ErkkaWS/3D-Robotics-H.E.I.K.K.I/Additional Documentation/20260302_133144.jpg

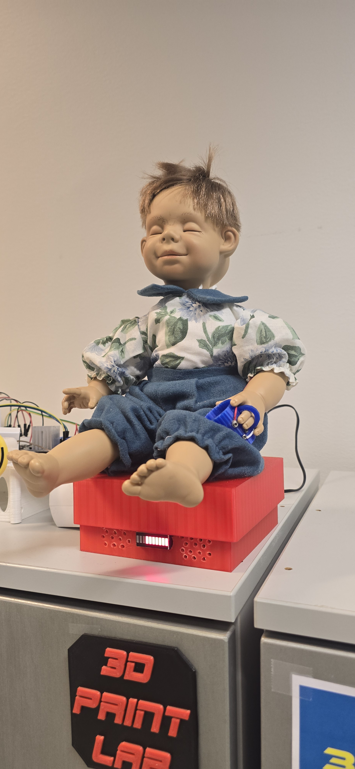
Additional Documentation/20260302_133144.jpg
