ErkkaWS/3D-Robotics-H.E.I.K.K.I/Additional Documentation/IMG-20260227-WA0012 (2).jpg

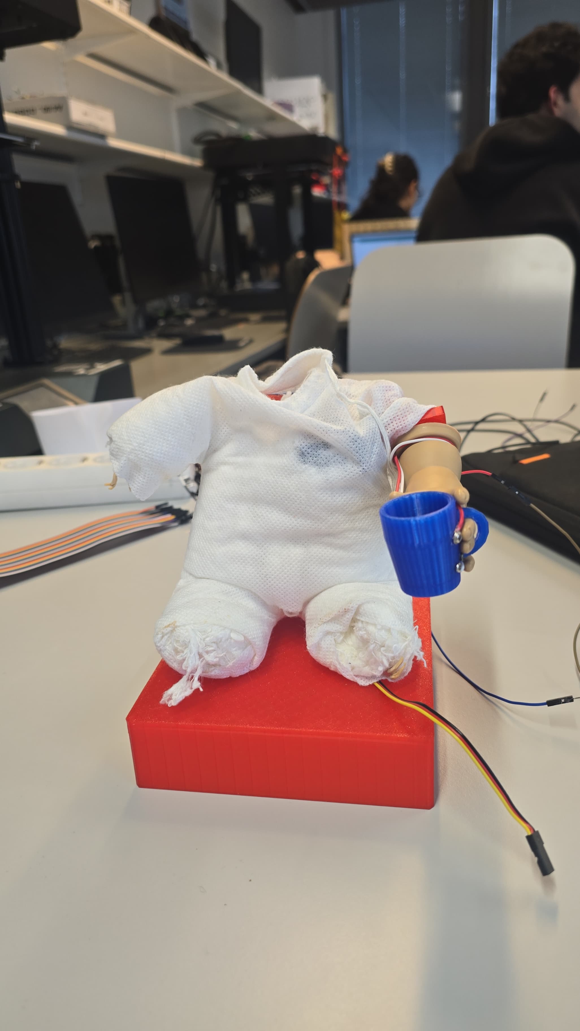
Additional Documentation/IMG-20260227-WA0012 (2).jpg
