ErkkaWS/3D-Robotics-H.E.I.K.K.I/Additional Documentation/20260226_091918.jpg

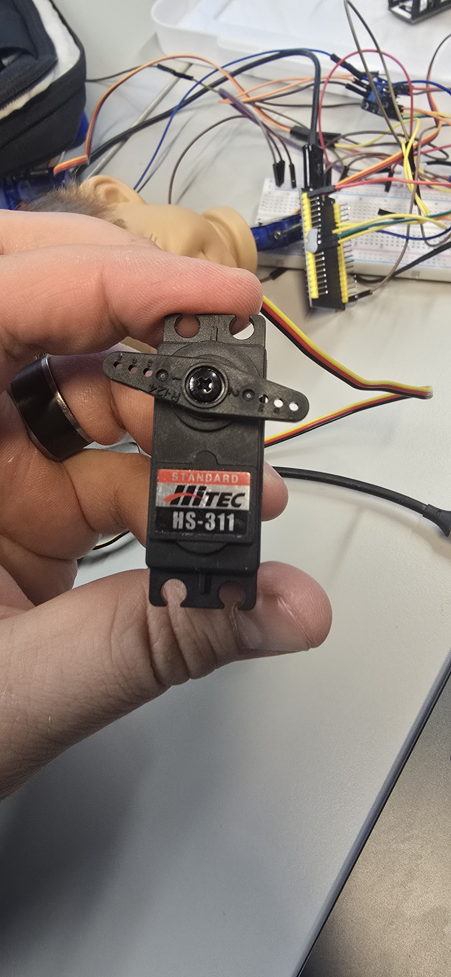
Additional Documentation/20260226_091918.jpg
