ErkkaWS/3D-Robotics-H.E.I.K.K.I/Additional Documentation/IMG20260223083320.jpg

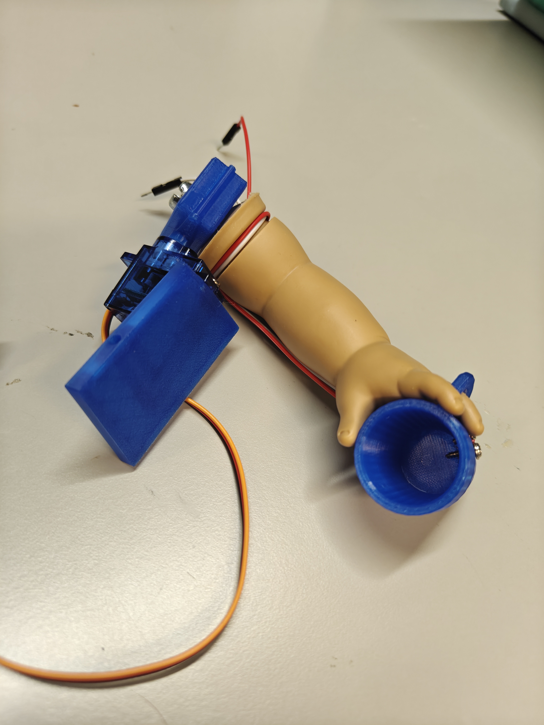
Additional Documentation/IMG20260223083320.jpg
