ErkkaWS/3D-Robotics-H.E.I.K.K.I/Additional Documentation/IMG-20260227-WA0009.jpeg

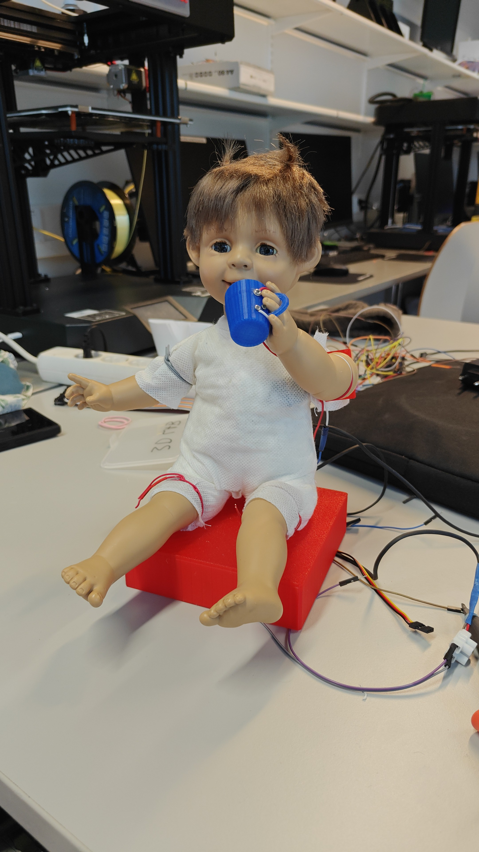
Additional Documentation/IMG-20260227-WA0009.jpeg
