ErkkaWS/3D-Robotics-H.E.I.K.K.I/Additional Documentation/Screenshot_20260304_211622_Gallery.jpg

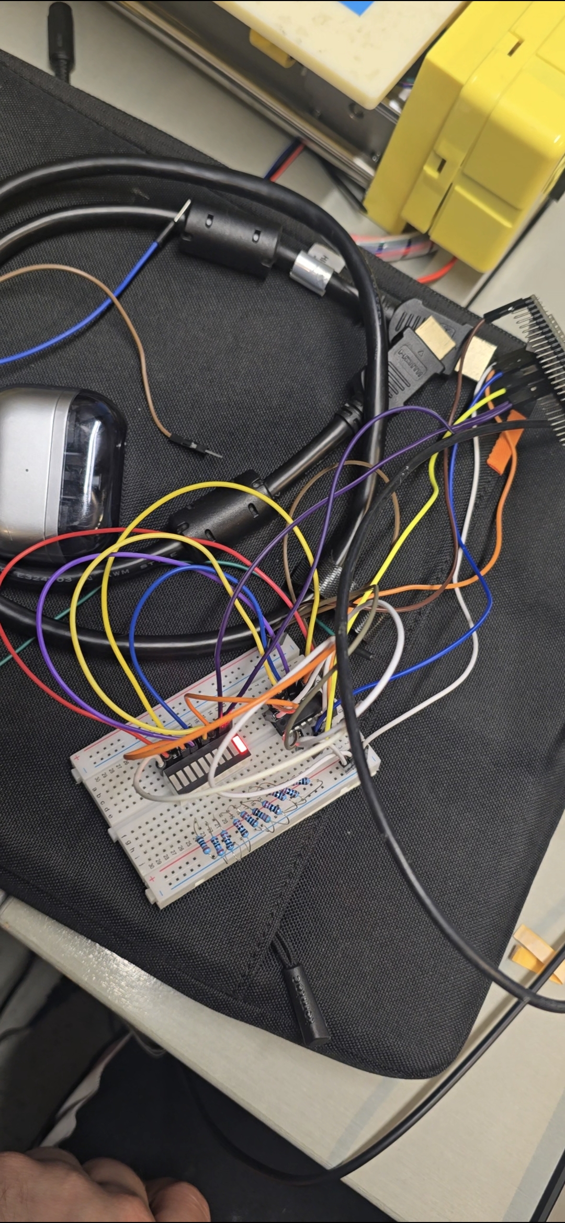
Additional Documentation/Screenshot_20260304_211622_Gallery.jpg
