ErkkaWS/3D-Robotics-H.E.I.K.K.I/(list of files, cad)

Other CAD files:
Blender models/Arm_L_Attachement.blend
Blender models/BaseNametag4.blend
Blender models/Base_Top.blend
Blender models/Box_Bottom.blend
Blender models/Cup.blend
Blender models/Torso_Plate.blend
Blender models/Torso_Skeleton.blend
